FranciscaDB/Platforms/JetBot with Jetson Nano/README.md

# Jetbot with Jetson Nano 

This guide is based on the [JetBot Website](https://jetbot.org/master/index.html) and [JetBot GitHub](https://github.com/NVIDIA-AI-IOT/jetbot/tree/master), considering modifications in the Bill of Material in our case, adaptations in the code, and tips at different stages based on our experience.

## Bill of Material per JetBot

| Part | Qty  | url |notes |
|:---:|:---:|:---:|:---:|
| Jetson Nano | 1 |[SparkFun - DLI Kit for Jetson Nano](https://www.sparkfun.com/sparkfun-dli-kit-for-jetson-nano.html)| 
| Micro SD card | 1 | [Amazon CA - Samsung EVO microSD 128GB](https://www.amazon.ca/SAMSUNG-Adaptor-Expanded-MB-MC128SA-CA/dp/B0D37XXQ5N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) | We used one of 64GB but ideally 128GB | 
| Motor DC | 2 | [Amazon CA - Adafruit DC Gearbox Motor "TT Motor" 200RPM 3 to 6 VDC](https://www.amazon.ca/Adafruit-DC-Gearbox-Motor-TT/dp/B07JXZ6TX8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) | "TT" form factor without encoder |
| Motor Driver | 1 | [Mouser CA - DC Motor + Stepper FeatherWing Add-on For All Feather Boards](https://www.mouser.ca/ProductDetail/Adafruit/2927?qs=ivJcBTDythUMt4thpvI5VA%3D%3D) | |
| Caster ball | 1 | [Amazon CA - 1-inch POM Coin Ring Making Balls](https://www.amazon.ca/uxcell-1-inch-Making-Plastic-Bearing/dp/B0B5XLGRY7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) | 1-inch diameter |
| USB cable pack | 1 | [Amazon CA - 90 Degree 25cm/9in USB A Left Angle to Micro USB Right Angle](https://www.amazon.ca/Degree-Micro-Charging-Transfer-Camera/dp/B0BXYDNS7C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) |  2 x USB Type A to Micro, right angle |
|  PiOLED display | 1 | [Amazon CA - Ferwooh PiOLED 0.91inch OLED Screen Display Module I2C 128X32 SSD1306](https://www.amazon.ca/Ferwooh-0-91inch-Display-SSD1306-Raspberry/dp/B08DHX5P5V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) | |
|  PiOLED header | 1 | [Amazon CA - 2.54mm 2 x 20-pin Male Double Row Right Angle Pin Header Strip](https://www.amazon.ca/Uxcell-a15010500ux0918-2-54mm-20-pin-Double/dp/B00W8TSWXS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) | 2 row x 3 pins right angle male |
|  WiFi Card | 1 | [Amazon CA - Intel Dual Band Wireless-Ac 8265 w/Bluetooth 8265.NGWMG](https://www.amazon.ca/Intel-Dual-Wireless-Ac-Bluetooth-8265-NGWMG/dp/B01MZA1AB2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) | M2, Intel Wireless-AC 8265 |
| WiFi antenna | 2 | [Mouser CA - 204281-1100 Molex](https://www.mouser.ca/ProductDetail/Molex/204281-1100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) |  U.FL connectors |
| dongle | 1 | [Amazon CA - AC1300 tp-link Archer T3U](https://www.amazon.ca/TP-Link-Archer-T3U-Adapter-Wireless/dp/B07P6N2TZH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) |  This is another option instead the WiFi Card + WiFi Antennas  |
|  Battery | 1 | [Amazon CA - AsperX 2-Pack 10000mAh](https://www.amazon.ca/gp/product/B09JBKDSP9/ref=ppx_yo_dt_b_asin_title_o01_s00?ie=UTF8&th=1) |  Dimensions must be smaller than 7.4 x 2 x 13.5 cm for the 3D part and WITHOUT an intelligent battery shutdown feature for low charges. |
| Camera | 1 | [Amazon CA - Yahboom 8MP IMX219 CSI](https://www.amazon.ca/Yahboom-Compatible-Developer-3280%C3%972464-160%C2%B0Camera/dp/B0C584LT6F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) | 15pin cable for interfacing to Jetson Nano |
| Skinny Wheel for TT DC Gearbox Motors |  2 | [Mouser CA - 3757 Adafruit](https://www.mouser.ca/ProductDetail/Adafruit/3757?qs=sGAEpiMZZMtyU1cDF2RqUPO2w5%252BTM236nQewAbJfYxw%3D) | 60mm diameter |
|  Adhesive Strips (Poster Strips) | 1 | [Amazon CA - Command Poster Hanging Strips](https://www.amazon.ca/Command-Poster-Hanging-60-Pairs-17024-60ES/dp/B00BT0MW4W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) | |
| M2 screw | 1 | [Amazon CA - M2x8mm Stainless Steel Hex Socket Cap Head Self Tapping Screws](https://www.amazon.ca/Hexagon-Socket-Tapping-Screws-Fasteners/dp/B00YBMRAH4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) | 8mm long, self tapping |
| M3 screw | 1 | [Amazon CA - M3 x 25mm 304 Stainless Steel Cross Head ](https://www.amazon.ca/uxcellM3-Stainless-Steel-Phillips-Screws/dp/B012TE0S6U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) | 25mm long |
| M3 nut | 1 | [Amazon CA - M3 Hex Nuts](https://www.amazon.ca/binifiMux-M1-6-Stainless-Steel-200pcs/dp/B08N68W9SP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) | |
| Jumper wires | 1 | [Amazon CA - Female to Female Breadboard Jumper Wire 2.54mm](https://www.amazon.ca/uxcell%C2%AE-Female-Jumper-2-54mm-Breadboard/dp/B07G39X4V2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) |  Female-female, ~20cm  |

## Software Setup

For the hardware setup, we followed: [JetBot Website - Software Setup](https://jetbot.org/master/software_setup/sd_card.html). Specifically, we used the [pre-built JetBot SD card image](https://nvidia.box.com/shared/static/4su20xg3w0mtvna99jr21m8ix80jhe5y.zip):

- Platform: Jetson Nano 2GB
- JetPack Version: 4.5
- JetBot Version: 0.4.3
- Download: jetbot-043_nano-2gb-jp45.zip
- MD5 Checksum: e6dda4d13b1b1b31f648402b9b742152

To flash the image onto the microSD card, we used BalenaEtcher. At least on Windows 10, we noticed that after flashing (and every time we connected the microSD to the computer), many partitions appeared on the card. This is normal ([NVidia Forum - After writing Jetson Nano .img file, my sd card is suddenly divided in multiple partitions](https://forums.developer.nvidia.com/t/after-writing-jetson-nano-img-file-my-sd-card-is-suddenly-divided-in-multiple-partitions/78197)).

It is important that for browsing http://<jetbot_ip_address>:8888 after successfully flashing the SD card, both the computer and the JetBot must be on the local network.

**In case you use the dongle instead of the WiFi Card + WiFi Antennas, the configuration from the [NVidia Forum - TPLink AC1300 WiFi Adapter](https://www.amazon.ca/TP-Link-Archer-T3U-Adapter-Wireless/dp/B07P6N2TZH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) must be applied in the Jetson Nano terminal (through SSH or Serial like PuTTY).**

## Hardware Setup

For the hardware setup, we followed: [JetBot Website - Hardware Setup](https://jetbot.org/master/hardware_setup.html). In the [3D Printing Files](https://github.com/FranciscaDB/Jetbot_ROS/tree/main/JetBot%20with%20Jetson%20Nano/3D%20Printing%20Files) folder, you will find the .stl files for the 3D printing of the various JetBot parts. Additionally, there is an image with more details about the printing setup.

Some tips for the hardware setup:

1. Before assembling the JetBot, test each component by connecting it to the Jetson Nano with the correctly flashed SD card. This way, you can ensure that the different components are working before securing them.
2. Try to clean each hole well where the screws will go. Try screwing them in by themselves first before adding the components to make it easier later.
3. If a screw doesn't go all the way in, you can use a nut to keep the component from being loose.
4. For the OLED display, we took out the head of the female jumper and soldered it to the pins of the 2x3 PiOLED header to make them female, so they would fit into the 6 pins of the pin header on the Jetson Nano Dev Kit.
5. After soldering or connecting any cable, check with a multimeter for continuity where it should be, and make sure there is NO continuity where it shouldn't be.
6. To connect the CSI camera, you must "unlock" the connector's latch! It's not as simple as just plugging it in. Be careful with this.

## Usage Tips

The use of Jupyter Notebook is quite straightforward. Below are some comments about it:

To install packages in Jupyter Notebook, you can do it in a new cell:
```bash
!pip3 install <package>
```

To see the source code of a function, library, or file, you can do it in a new cell:

```bash
print(inspect.getfile(<name of function, library or file>))  # This gives you the path
```

and then:
```bash
!cat <path>
```

The exclamation symbol "!" is used to run OS commands directly.

## Examples

The JetBot image includes several examples. These contain explanations of themselves and are well-guided. Our interest is in using this JetBot concept in Platooning, so we slightly modified the Road Following code (source files can be found in the [Jetbot_road_following](https://github.com/FranciscaDB/Jetbot_ROS/tree/main/JetBot%20with%20Jetson%20Nano/Jetbot_road_following) folder) to include communication between JetBots, thus controlling only one instead of each one.
