FranciscaDB/Platforms/JetBot with Jetson Nano/3D Printing Files/chassis.stl

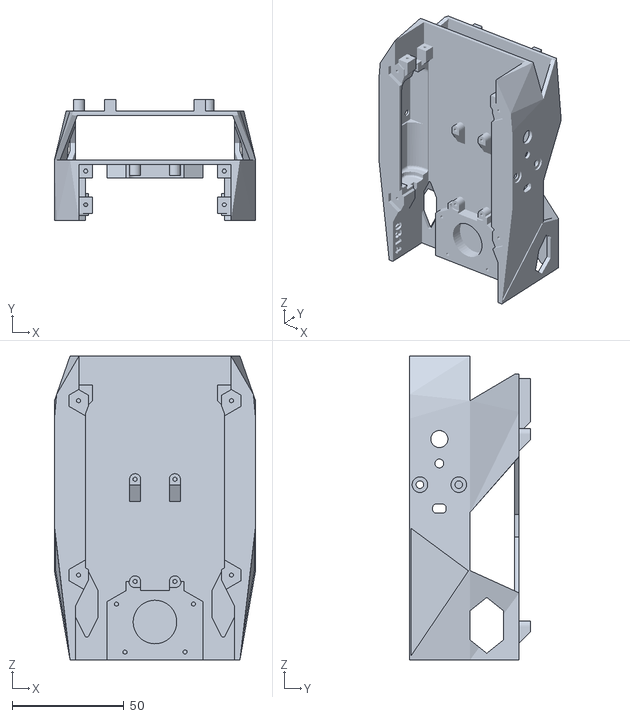
[picture p5: CAD file, 2025-06-11]
JetBot with Jetson Nano/3D Printing Files/chassis.stl
90.0 x 54.0 x 136.0
