FranciscaDB/Platforms/JetROS/physical_build/3D_files/4th_floor.stl

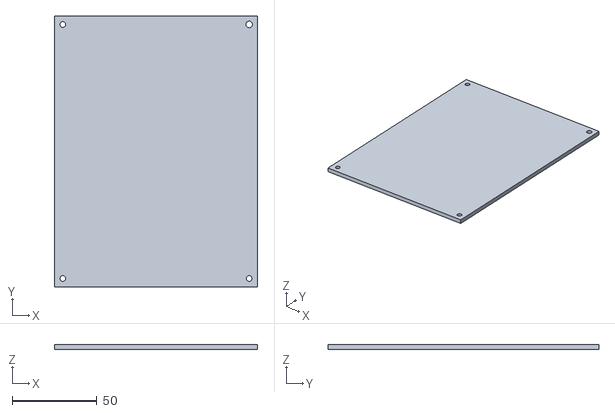
[picture p6: CAD file, 2025-06-22]
JetROS/physical_build/3D_files/4th_floor.stl
120.0 x 160.0 x 3.00
