FranciscaDB/Platforms/JetBot with Jetson Nano/3D Printing Files/camera_mount.stl

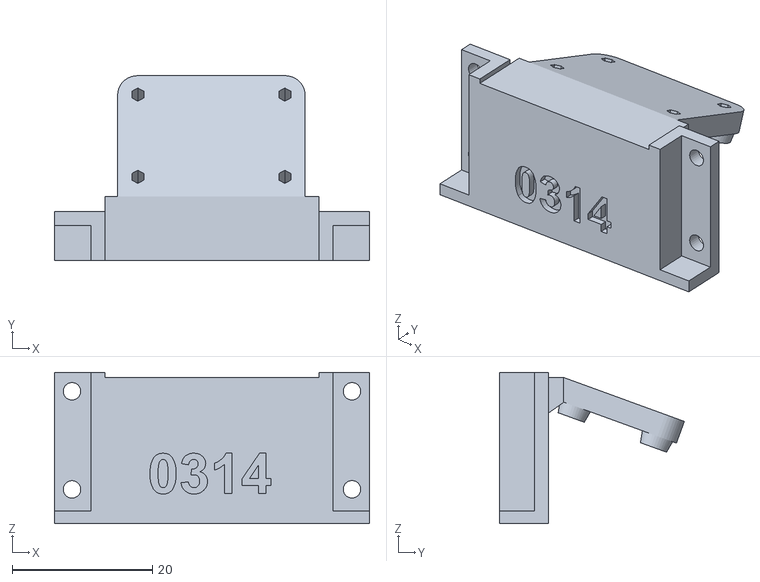
[picture p7: CAD file, 2025-06-11]
JetBot with Jetson Nano/3D Printing Files/camera_mount.stl
45.0 x 26.4 x 21.6
