FranciscaDB/Platforms/JetROS/physical_build/3D_files/1st_floor.stl

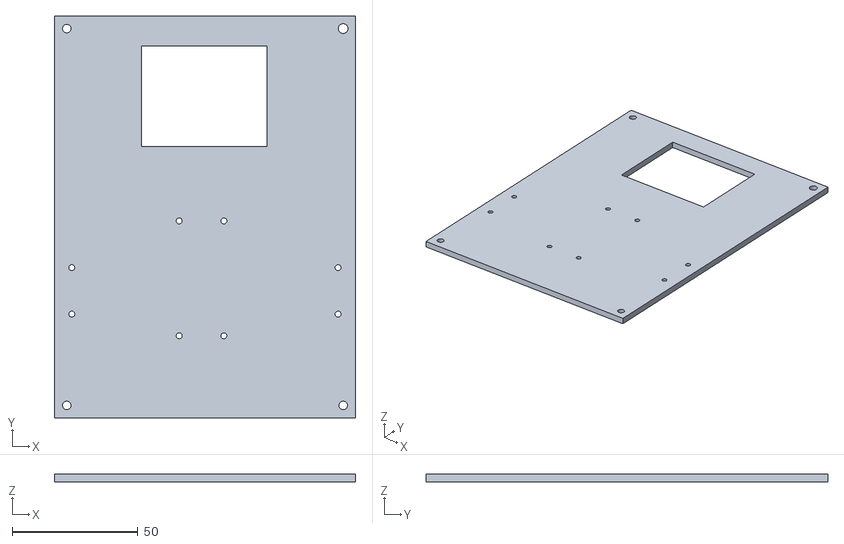
[picture p8: CAD file, 2025-06-22]
JetROS/physical_build/3D_files/1st_floor.stl
120.0 x 160.0 x 3.00
