FranciscaDB/Platforms/JetROS/physical_build/3D_files/N20_Motor_Mounting_Bracket_R.stl

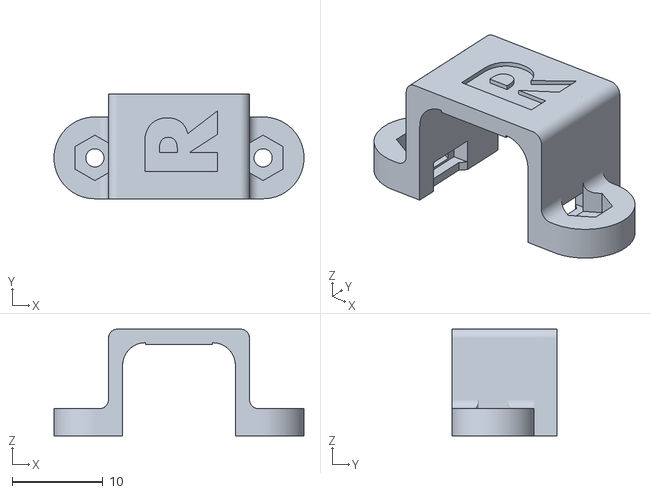
[picture p10: CAD file, 2025-06-22]
JetROS/physical_build/3D_files/N20_Motor_Mounting_Bracket_R.stl
27.5 x 11.5 x 11.8
