FranciscaDB/Platforms/JetROS/physical_build/3D_files/caster_base_60mm.stl

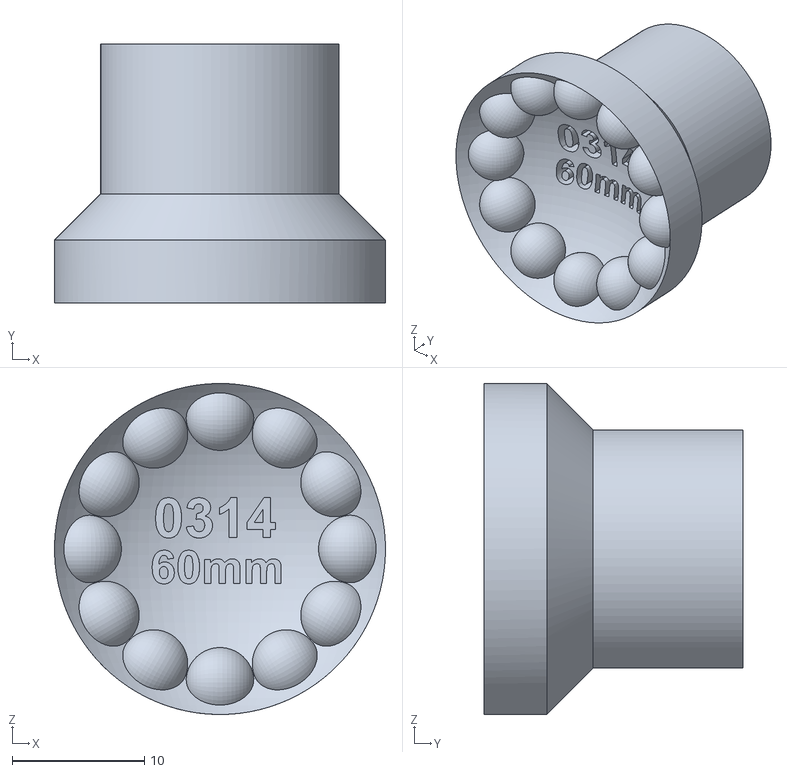
[picture p11: CAD file, 2025-06-11]
JetROS/physical_build/3D_files/caster_base_60mm.stl
25.0 x 19.5 x 25.0
