FranciscaDB/Platforms/JetROS/physical_build/3D_files/caster_shroud_60mm.stl

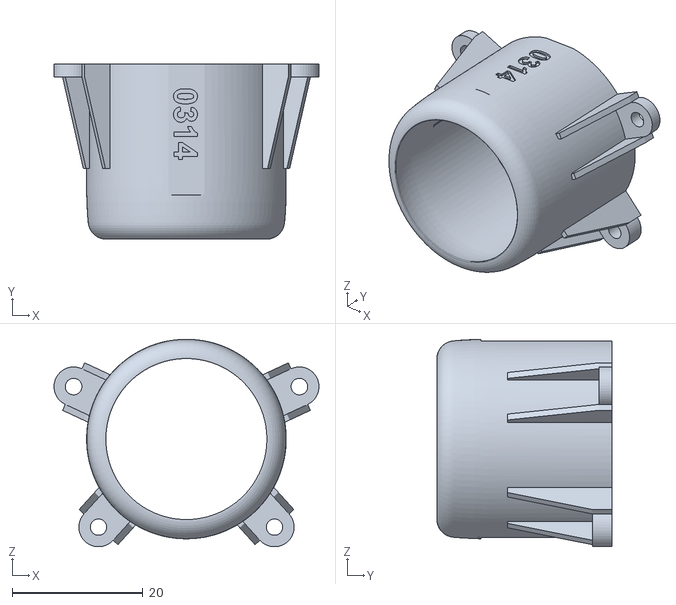
[picture p12: CAD file, 2025-06-11]
JetROS/physical_build/3D_files/caster_shroud_60mm.stl
40.5 x 26.8 x 31.7
