FranciscaDB/Platforms/(list of files, cad)

Other CAD files:
JetROS/physical_build/3D_files/3rd_floor.stl
JetROS/physical_build/3D_files/N20_Motor_Mounting_Bracket_L.stl
