FranciscaDB/Platforms/JetROS/physical_build/README.md

### Connections:
| Jetson Orin Nano | Motor Driver | Encoder L | Encoder R |
|---|---|---|---|
| 1 | 3V3 | | |
| 2 | | VCC | |
| 3 | SDA | | |
| 4 | | | VCC |
| 5 | SCL | | |
| 6 | GND | | |
| 9 | | | GND |
| 11 | | | C1 |
| 12 | | | C2 |
| 14 | | GND | |
| 15 | | C1 | |
| 16 | | C2 | |
| N/A | M1 | M1-M2 | |
| N/A | M2 | | M1-M2 |

<p align="center">
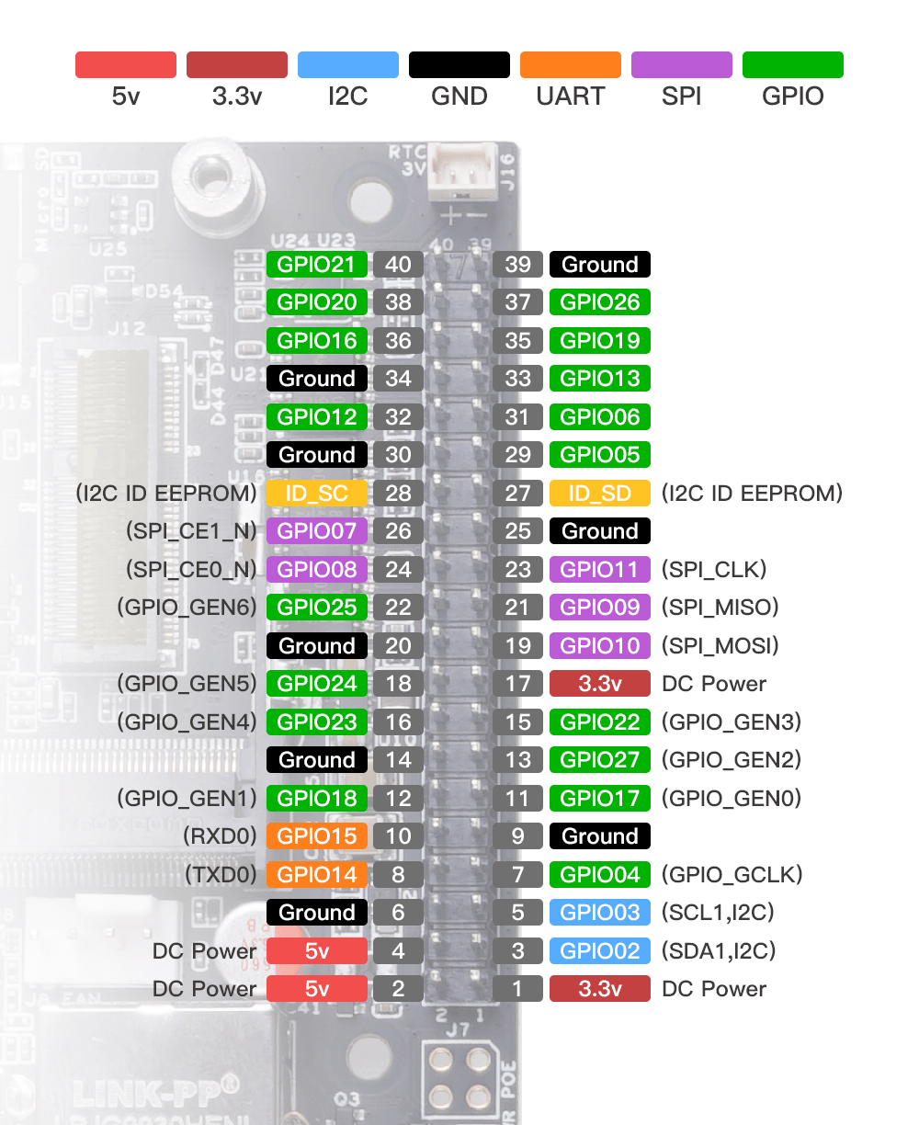
[picture p13: JetROS/physical_build/pins_orin.png]

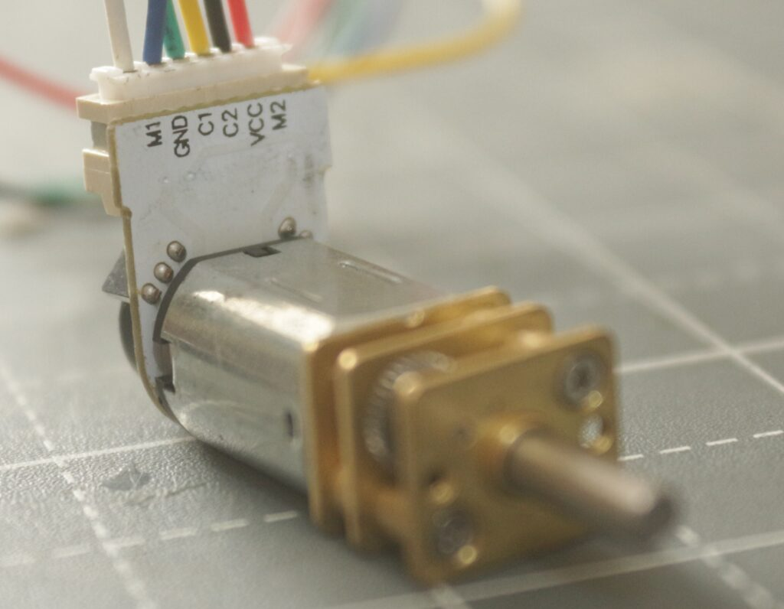
[picture p14: JetROS/physical_build/encoder.jpg]

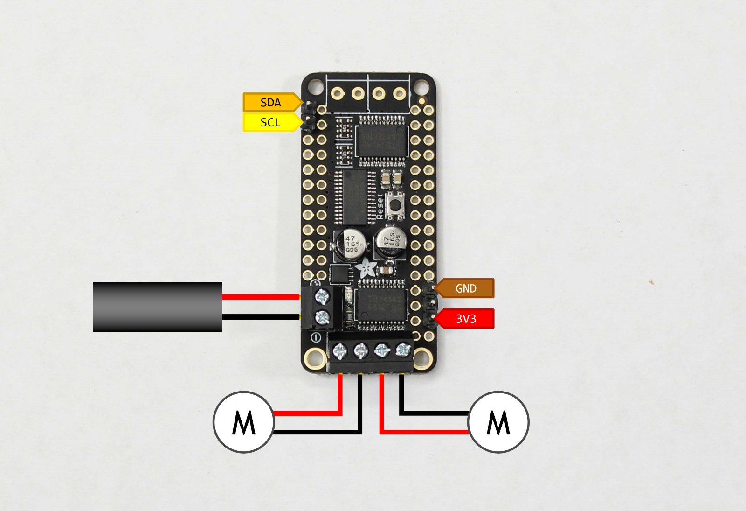
[picture p15: JetROS/physical_build/driver.png]

</p>

## Bill of Materials per Robot
| Part | Qty  | url |notes |
|:---:|:---:|:---:|:---:|
| Jetson Orin Nano | 1 |[Amazon CA - NVIDIA Jetson Orin Nano Super Developer Kit](https://www.amazon.ca/NVIDIA-Jetson-Orin-Nano-Developer/dp/B0BZJTQ5YP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)|
| UPS Module (C) For Jetson Orin | 1 |[Waveshare - UPS Module (C) For Jetson Orin](https://www.waveshare.com/ups-power-module-c.htm)|
| 21700 Li battery | 2 |[Amazon CA - 21700 Li battery](https://www.amazon.ca/Rechargeable-21700genuine-Batteries-Flashlight-Headlamp/dp/B0BPNGQ6N8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)| 3 are required | 
| Slamtec RPLIDAR C1 | 1 |[Amazon CA - Slamtec RPLIDAR C1](https://www.amazon.ca/RPLIDAR-Omnidirectional-Millimeter-Level-Anti-Interference-Anti-Adhesion/dp/B0CX1N4JNZ)|
| Micro SD card | 1 | [Amazon CA - Samsung EVO microSD 128GB](https://www.amazon.ca/SAMSUNG-Adaptor-Expanded-MB-MC128SA-CA/dp/B0D37XXQ5N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) | | 
| Motor Driver | 1 | [Mouser CA - DC Motor + Stepper FeatherWing Add-on For All Feather Boards](https://www.mouser.ca/ProductDetail/Adafruit/2927?qs=ivJcBTDythUMt4thpvI5VA%3D%3D) | |
| Caster ball | 1 | [Amazon CA - 1-inch POM Coin Ring Making Balls](https://www.amazon.ca/uxcell-1-inch-Making-Plastic-Bearing/dp/B0B5XLGRY7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) | 1-inch diameter |
| USB cable pack | 1 | [Amazon CA - 90 Degree 25cm/9in USB A Left Angle to Micro USB Right Angle](https://www.amazon.ca/Degree-Micro-Charging-Transfer-Camera/dp/B0BXYDNS7C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) |  USB Type A to Micro, right angle |
|  Battery | 1 | [Amazon CA - AsperX 2-Pack 10000mAh](https://www.amazon.ca/gp/product/B09JBKDSP9/ref=ppx_yo_dt_b_asin_title_o01_s00?ie=UTF8&th=1) |  WITHOUT an intelligent battery shutdown feature for low charges. |
| RGB Camera | 1 |[Amazon CA - USB Webcam](https://www.amazon.ca/Microphone-Streaming-Conferencing-110-Degree-Widescreen/dp/B081Z2NX9W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)|
|  Adhesive Strips (Poster Strips) | 1 | [Amazon CA - Command Poster Hanging Strips](https://www.amazon.ca/Command-Poster-Hanging-60-Pairs-17024-60ES/dp/B00BT0MW4W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) | |
| Standoff | 1 |[Amazon CA - Standoff Kit 3M](https://www.amazon.ca/Lystaii-Standoff-Motherboard-Standoffs-Assortment/dp/B08LPYR49C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)| Ideally use metal standoff for robustness|
| Rubber Wheel | 1 |[Amazon CA - Rubber Wheel](https://www.amazon.ca/10pcs-43x19x3mm-D-Hole-Rubber-Suitable/dp/B0DQXQN5VF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)| Must have the D-hole for N20 motors|
