FranciscaDB/Platforms/JetBot with Jetson Nano/3D Printing Files/README.md

# 3D Printing Files

More information can be found at [JetBot Website - 3D Printing](https://jetbot.org/master/3d_printing.html).

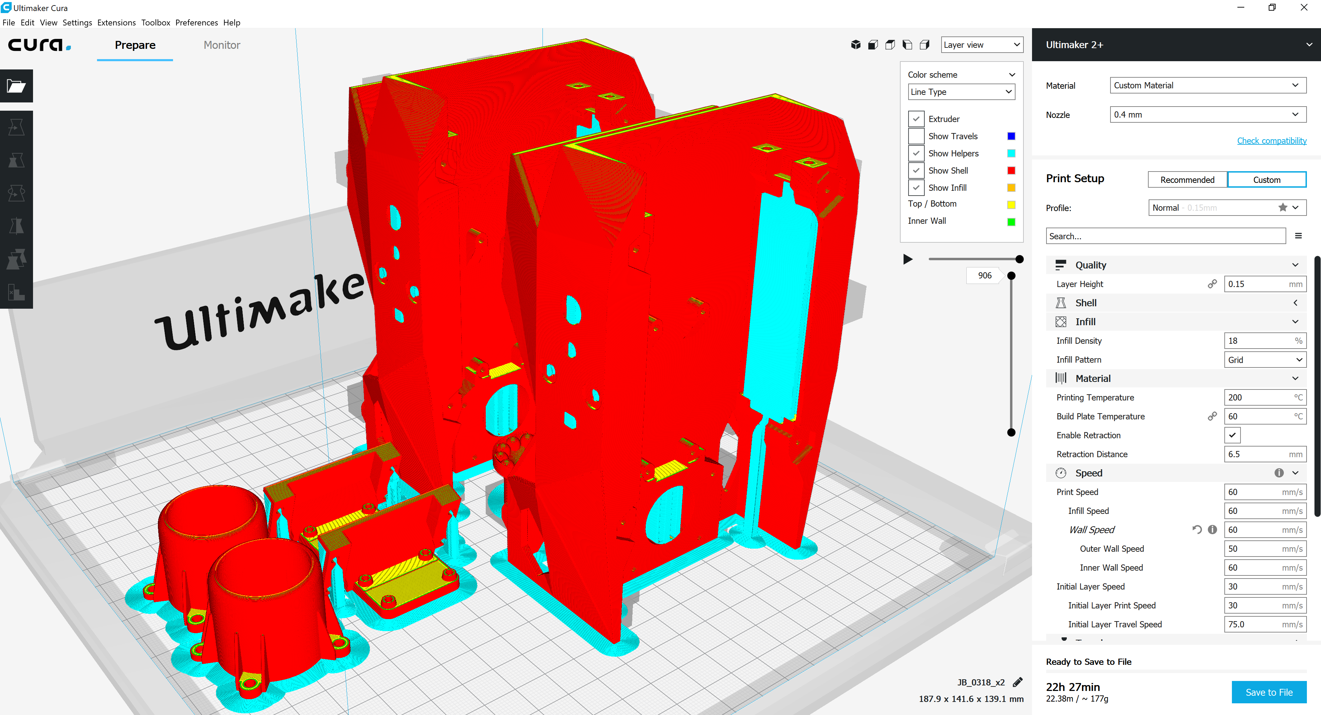
[picture p16: JetBot with Jetson Nano/3D Printing Files/Cura-Print-Setup_overall.png]
3D Printing Settings
