FranciscaDB/Platforms/(commit log)

2025-06-22 assembly folder
    [N20_Motor_Mounting_Bracket_L.stl, N20_Motor_Mounting_Bracket_R.stl]
2025-06-22 new folder
    [1st_floor.stl, 2nd_floor.stl, 3rd_floor.stl, 4th_floor.stl, N20_Motor_Mounting_Bracket_L.stl, N20_Motor_Mounting_Bracket_R.stl]
2025-11-10 Fix typo in Lidar Filter Node heading
